craigyjp/14bit-MIDI-to-CV/schematics/programmer.pdf

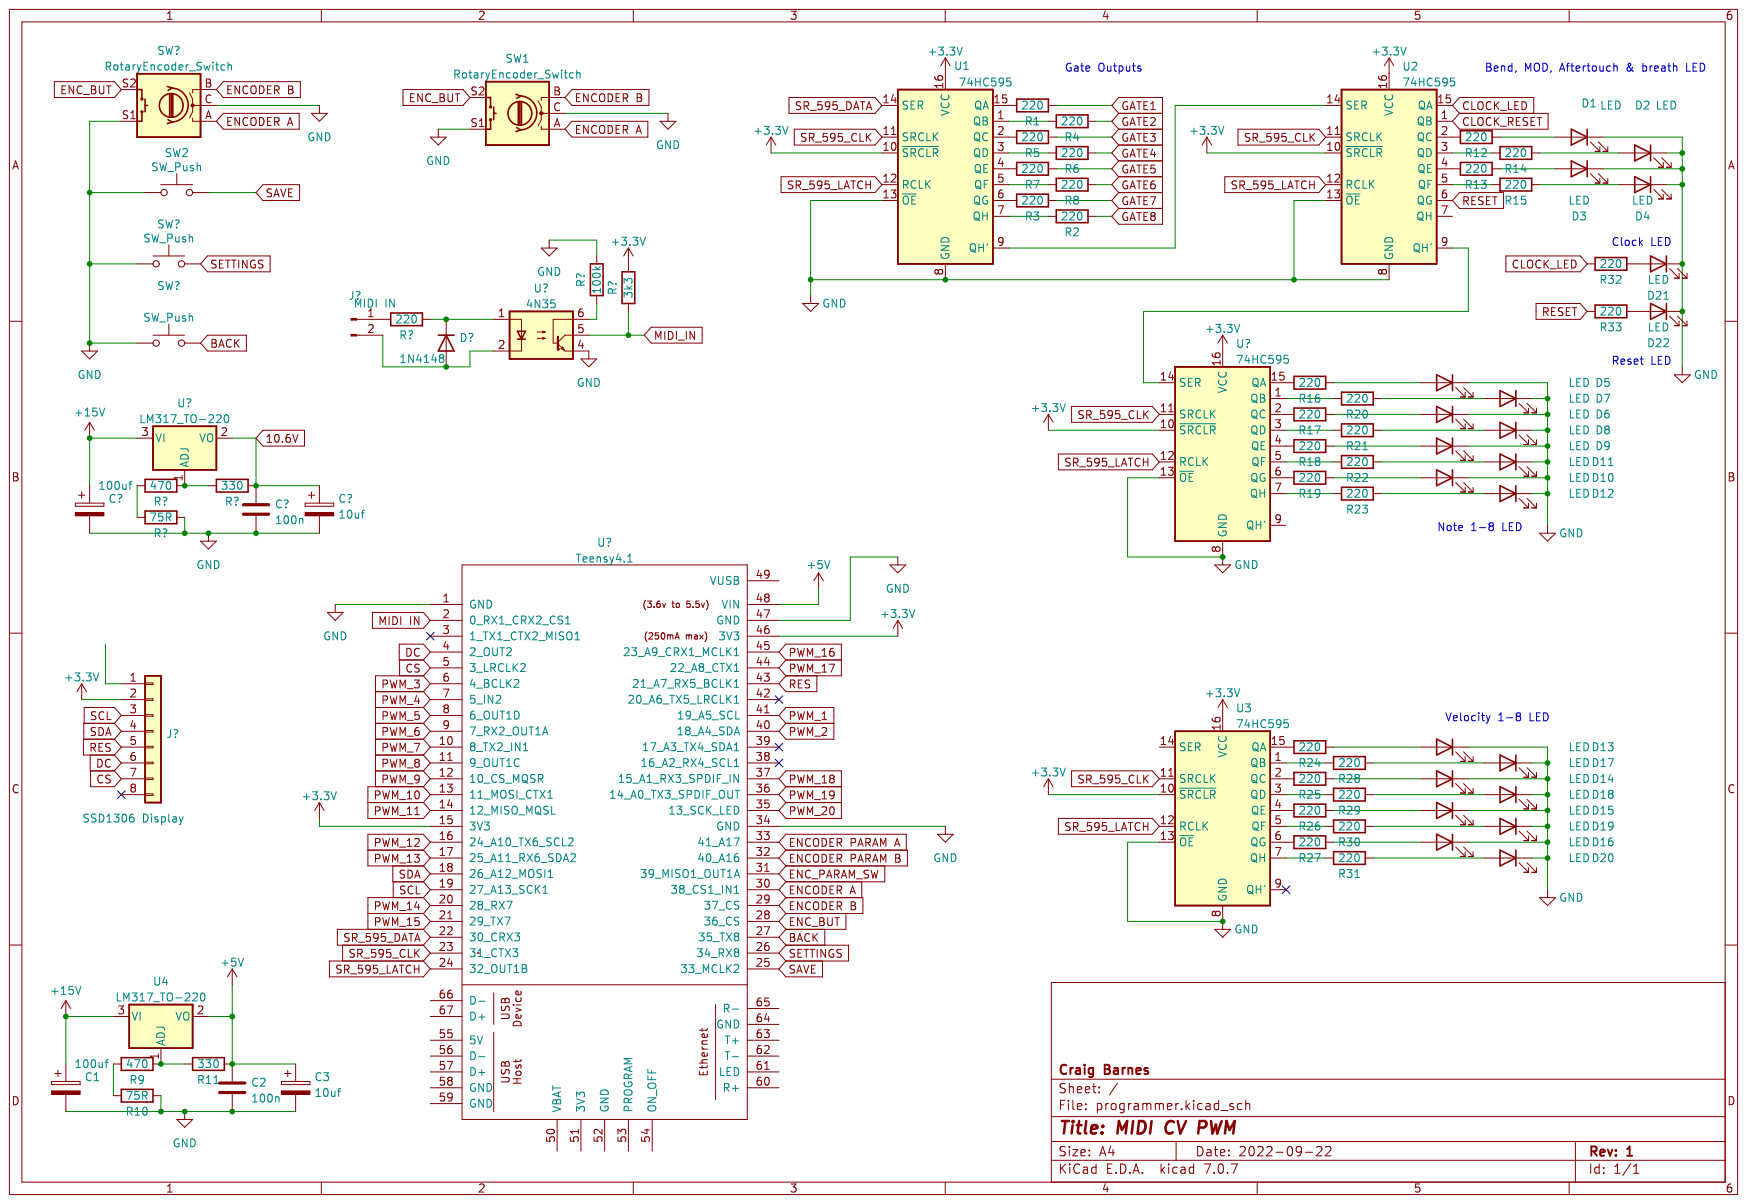
[picture p1: page 1]
