craigyjp/14bit-MIDI-to-CV/schematics/interface.pdf

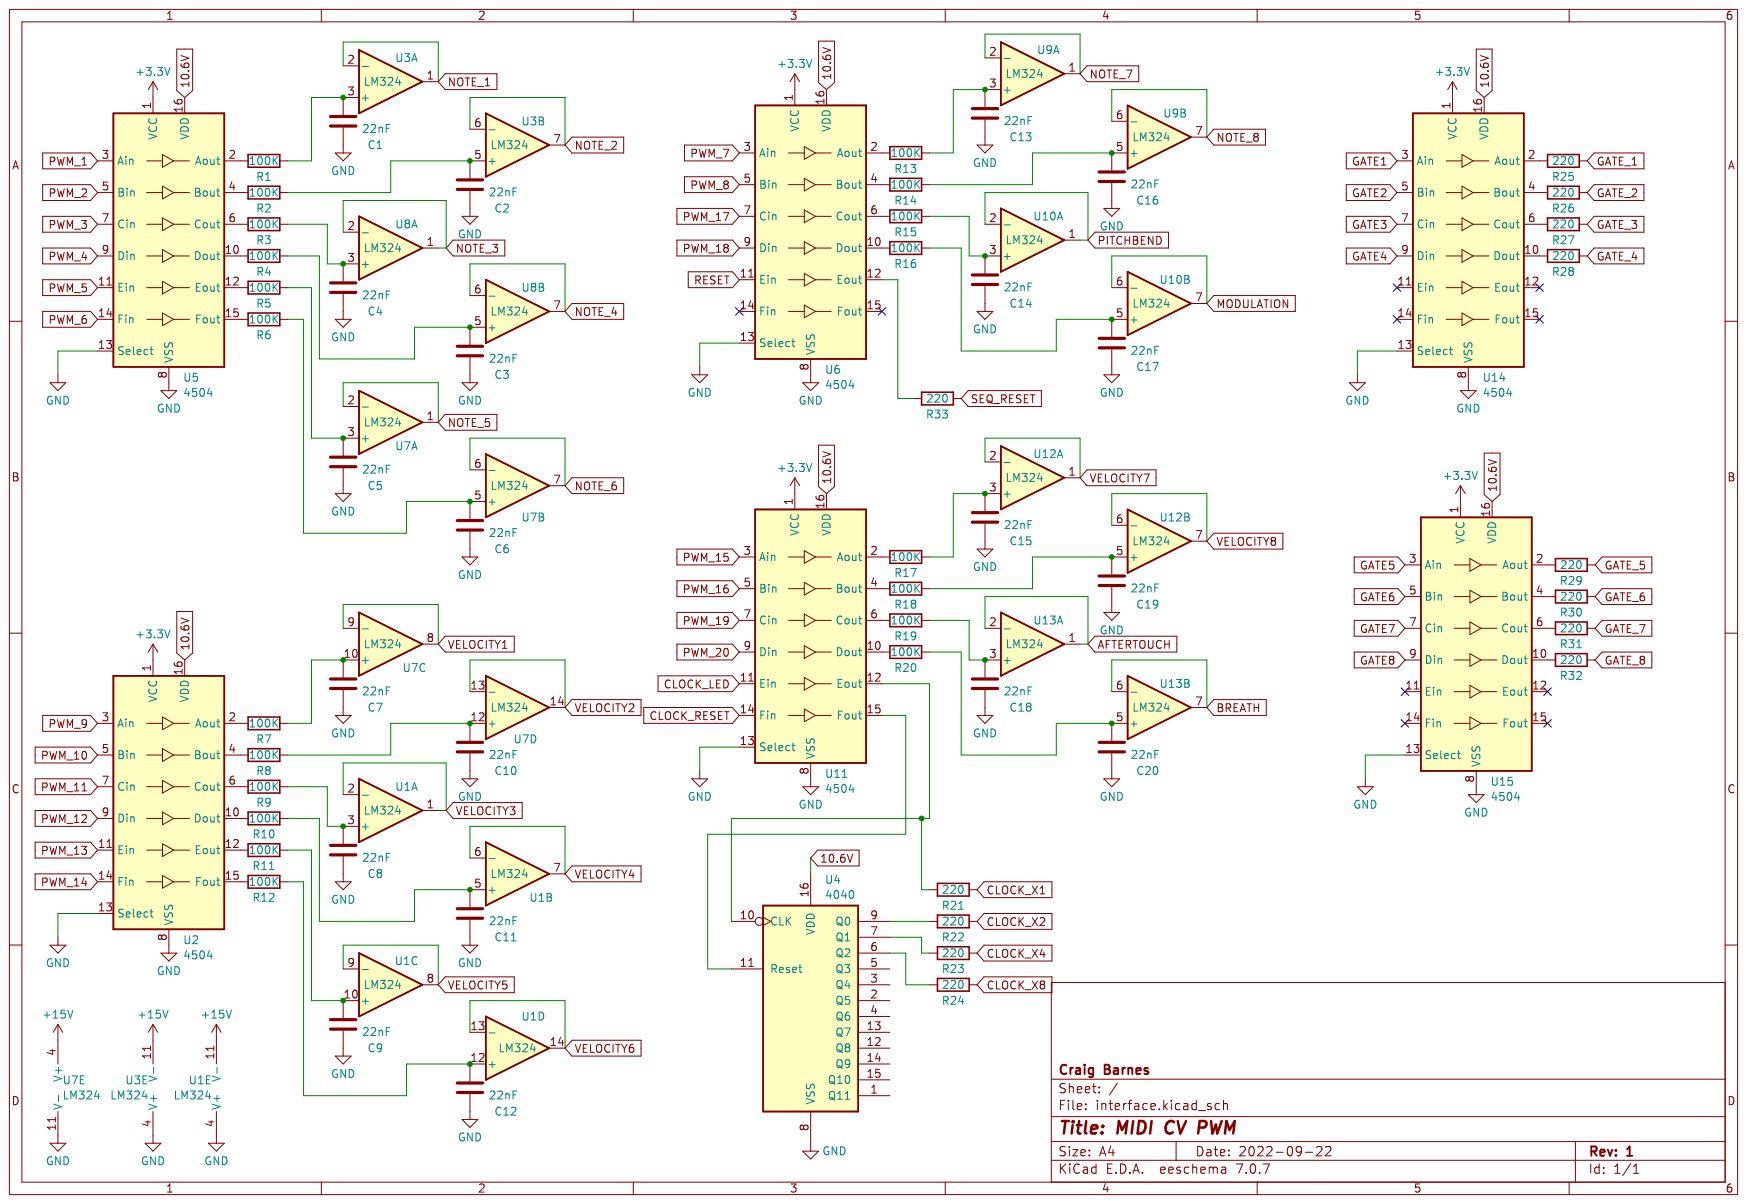
[picture p2: page 1]
