craigyjp/14bit-MIDI-to-CV/src/Constants.h

const char* VERSION = "V1.5";

#define NO_OF_PARAMS 64
const char* INITPATCHNAME = "Initial Patch";
#define HOLD_DURATION 1000
const uint32_t CLICK_DURATION = 250;
#define PATCHES_LIMIT 999
#define CHANNEL_PARAMS 5
#define GATE_PARAMS 60
#define CHANNEL_CC_MAX 97
#define CHANNEL_CC_MIN 3
#define CHANNEL_MIDI_MAX 16
#define CHANNEL_MIDI_MIN 1

const String INITPATCH = "8 Note Poly,8,0,0,0,0,0,0,0,0,0,0,0,0,0,0,0,0,0,0,0,0,0,0,0,0";
