craigyjp/14bit-MIDI-to-CV/src/MidiCC.h

//MIDI CC control numbers
//These broadly follow standard CC assignments

#define   CCglideSpeed 5

#define   CCsynthVolume 11
#define   CCwaveMonoMulti  14
#define   CCADSRInvert  15
#define   CCglideAmount 16

#define   CCglideDest 20
#define   CCoscWaveform 23
#define   CCoctaveModSW 24//Off/On
#define   CCglideMonoMulti 26

#define   CCoctave2  30//Off/On
#define   CCsync  31//Off/On
#define   CCLfoDest 33
#define   CCLfoMonoMulti 37

#define   CCeffectNumber 43
#define   CCaltWave 44
#define   CCpot1 45
#define   CCpot2 46
#define   CCpot3 47
#define   CCeffect 48
#define   CCmix 49

#define   CCsynthInput 50
#define   CCstringsInput 51
#define   CCorganInput 52
#define   CCinternal 53
#define   CCfootSwitch 54

#define   CCLfoSlope 66

#define   CCosc1Detune 71
#define   CCamprelease  72
#define   CCampattack 73
#define   CCfilterCutoff  74

#define   CCampdecay  75
#define   CCLfoRate 77
#define   CCampsustain  79

#define   CCorganVolume 80
#define   CCstringsVolume 81
#define   CCorgan16 82
#define   CCorgan8 83
#define   CCorgan4 84
#define   CCorgan2 85
#define   CCtimbre 86
#define   CCfootages 87
#define   CCLfoDelay  88//MIDI Only
#define   CCstringAttack 89

#define   CCButtonA 90
#define   CCLFOWaveform  91
#define   CCButtonC 92
#define   CCButtonB 93
#define   CCfilterRes  94

#define   CCallnotesoff 123//Panic button
#define   CCoctave1  126//Off/On






#define   CCLfoDepth  95
#define   CCstringRelease 96
