craigyjp/14bit-MIDI-to-CV/(commit log)

2023-11-24 Created parameter menus and encoder
2023-12-02 Switched to an SPI display
2023-12-05 CC working 0-5V & 0-10V
2023-12-06 Added clock outputs and a clock reset
    [14bit_8_note_PWM_MIDI_CV_poly.ino, Constants.h, HWControls.h, Parameters.h]
2023-12-06 Initial schematics
2023-12-06 Added 5V reg to programmer
2023-12-07 Added output LEDs for all CVs
2023-12-07 Added LED indicators
2023-12-07 Added seq reset output on play
    [14bit_8_note_PWM_MIDI_CV_poly.ino, HWControls.h, Parameters.h]
2023-12-09 Added clock and reset LEDs
